galah-x/SwingGate/README.md

# SwingGate
Controller for an electric remote controlled swing farm gate
