galah-x/SwingGate/swinggate/swinggate_BOM.ods

Id | Designator | Package | Quantity | Designation | Supplier and ref
1 | U3 | IBT_2 | 1 | IBT2_HBRIDGE | https://www.ebay.com.au/itm/Semiconductor-Motor-Driver-Auto-BTS7960-43A-H-Bridge-PWM-Drive-For-Arduino-U1C6-/302749142576
3 | C1,C2,C3,C4,C5 | C_0805_2012Metric_Pad1.15x1.40mm_HandSolder | 5 | 100N
4 | D1 | D_SMA-SMB_Universal_Handsoldering | 1 | APD240VR
5 | J1,J3,J4,J5 | PhoenixContact_MC_1,5_2-G-5.08_1x02_P5.08mm_Horizontal | 4 | Conn_01x02_Female | https://www.ebay.com.au/itm/10pcs-5-08mm-2-EDG-2-Pin-Plug-in-Right-Angle-PCB-Screw-Terminal-Block-Connector/292835245321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
6 | Q1 | TO-263-3_TabPin2 | 1 | IPB081
7 | R3 | R_0805_2012Metric_Pad1.15x1.40mm_HandSolder | 1 | 402K
8 | R4,R9,R10,R11,R13,R15 | R_0805_2012Metric_Pad1.15x1.40mm_HandSolder | 6 | 100K
9 | R5,R6 | R_0805_2012Metric_Pad1.15x1.40mm_HandSolder | 2 | 10K
10 | R7,R8 | R_0805_2012Metric_Pad1.15x1.40mm_HandSolder | 2 | 1K2
11 | R12,R14,R16 | R_0805_2012Metric_Pad1.15x1.40mm_HandSolder | 3 | 33K
12 | U1 | switcher1 | 1 | switcher1 | https://www.ebay.com.au/itm/DC-DC-9V-12V-19V-To-3A-5V-3-3V-USB-Step-Down-Buck-Power-Supply-Module-For-Car/282743651974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
13 | U2 | DIP-26_W0.8_Socket | 1 | Moteino_hcw | https://lowpowerlab.com/shop/product/99
14 | J2 | PhoenixContact_MC_1,5_4-G-5.08_1x04_P5.08mm_Horizontal | 1 | Conn_01x04_Female | https://www.ebay.com.au/itm/9Pairs-4Pole-5-08mm-Plug-Type-Pitch-PCB-Mount-with-Right-Angle-Pin-B9U1/273040528477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
 | additional mechanical
 |  | threaded standoff 25mm m3 | 4 | for U3 | https://www.ebay.com.au/itm/100pcs-M3-5-25mm-Black-PA66-Nylon-Hexagon-Female-Threaded-Standoff-Spacer-Pillar/182482464251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
 |  | 8 pin header | 1 | for U3
 |  | ribbon cable 8 pin idc socket | 2 | for U3 | https://www.ebay.com.au/itm/2-54mm-FC-6-51-Way-IDC-Female-Flat-Ribbon-Cable-Mounting-Socket-Connector-Kit/222895237965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
 |  | ribbon cable 50mm | 1 | for U3
 |  | m3 machine screw 6mm | 8 | for U3 | https://www.ebay.com.au/itm/M3x10mm-316-Stainless-Steel-Phillips-Round-Pan-Head-Machine-Screw-Bolt-60pcs/352046660471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
 |  | pin strip x 13 mc screw female | 2 | for U2 | https://www.ebay.com.au/itm/2-10x-Strip-Tin-PCB-Female-IC-Breakable-40pin-Single-Row-Round-Header-Socket/161925149885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
 |  | pin strip x 13 mc screw male | 2 | for U2 | https://www.ebay.com.au/itm/20pcs-40Pin-2-54mm-Male-Female-Header-Socket-Row-Straight-Strip-PCB-Connector/152053905428
