galah-x/SwingGate/SwingGate.pdf

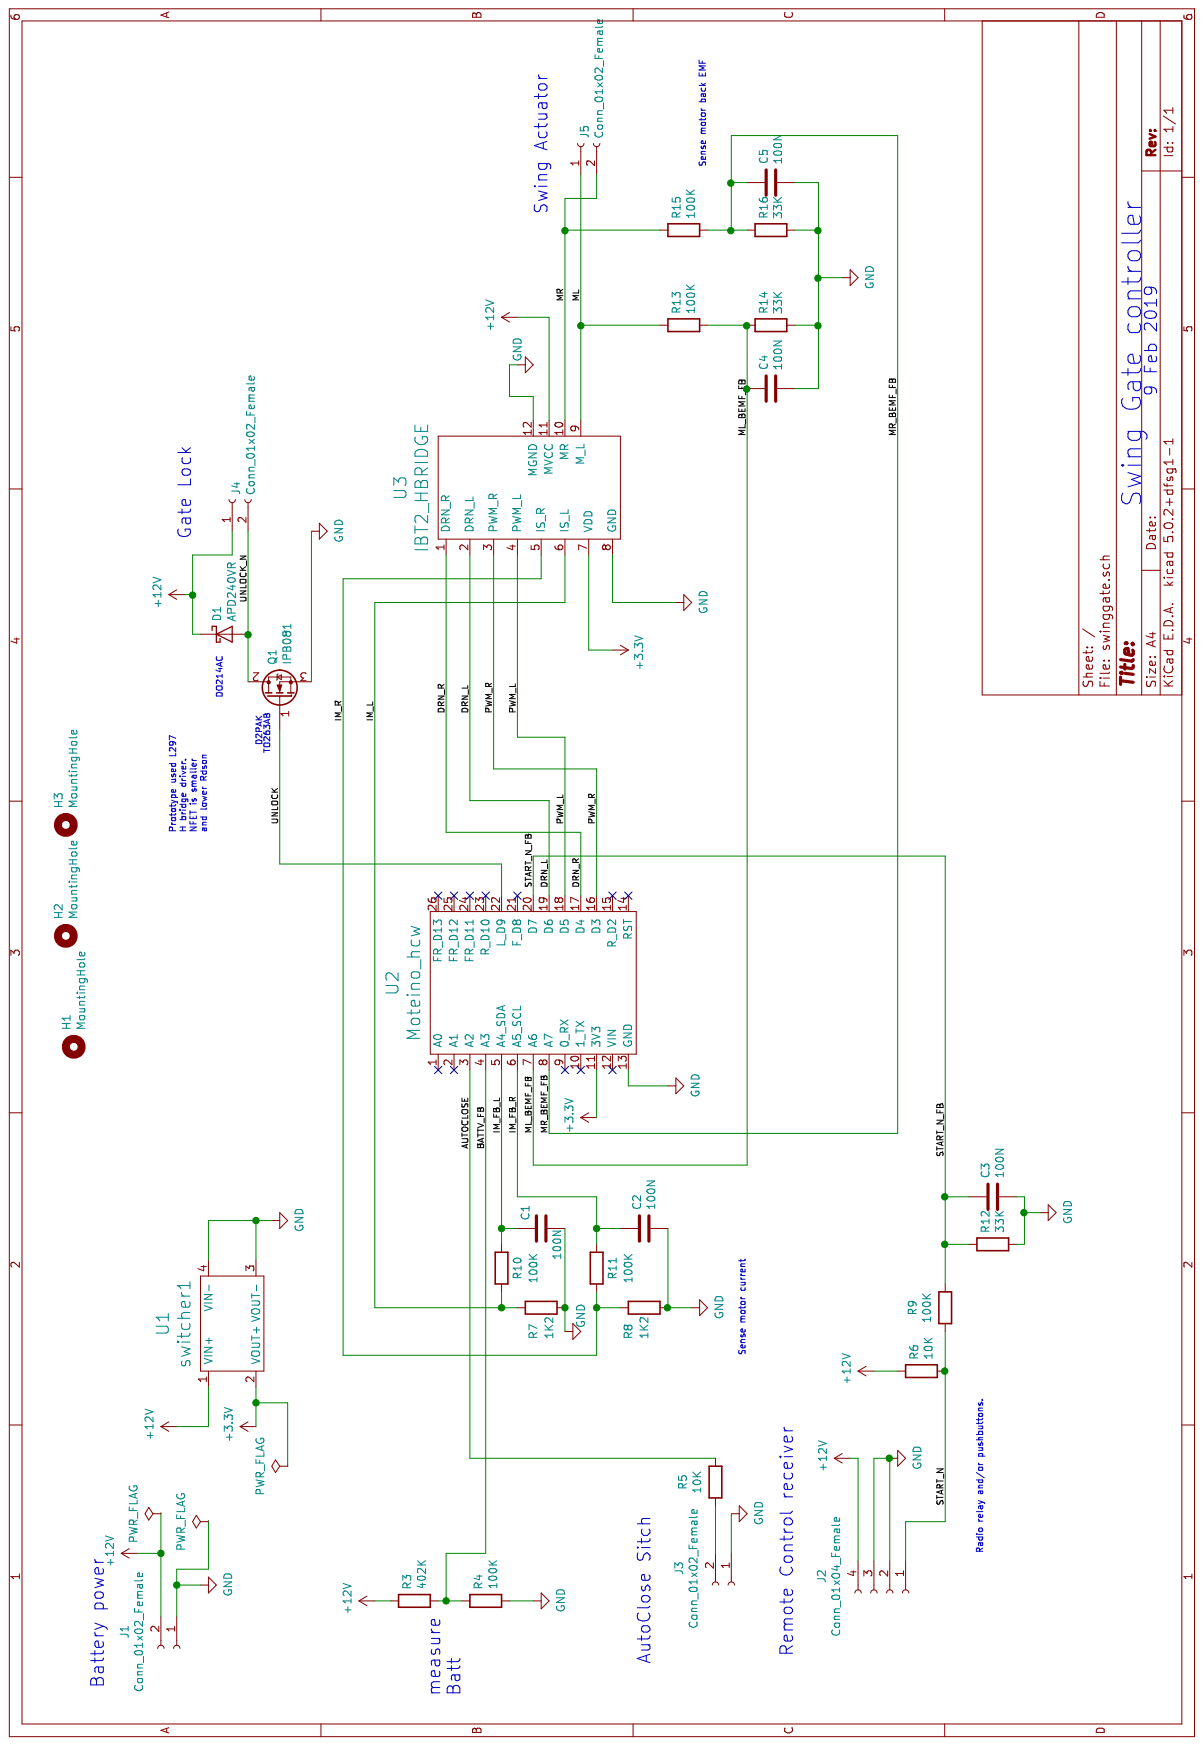
[picture p1: page 1]
