galah-x/SwingGate/swinggate/swinggate.kicad_pcb

## KiCad design swinggate/swinggate.kicad_pcb (2019-02-10)

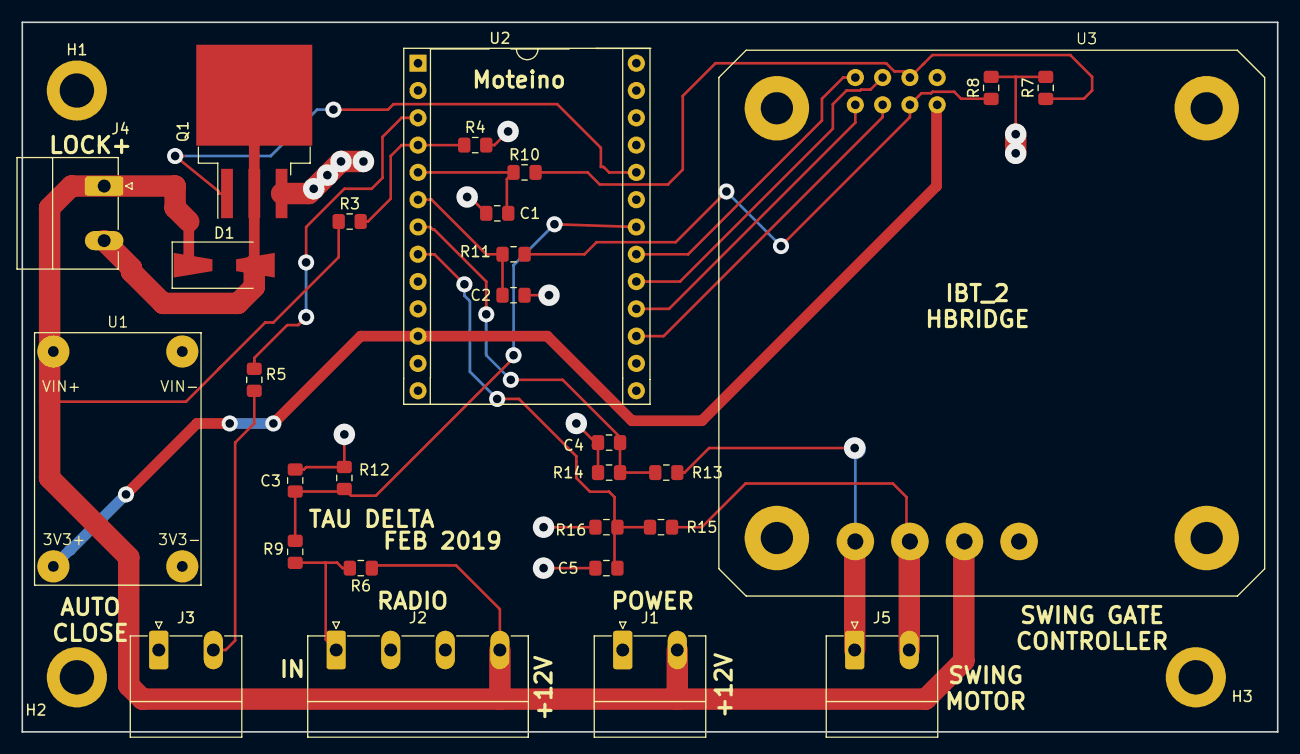
[picture p2: board swinggate.kicad_pcb from above]

Board: 2 copper layers, 116.8 x 66.0 mm, 32 parts (0 on the bottom side), 22 nets.

Parts:
C1, C2, C3, C4, C5: 100N; C_0805_2012Metric_Pad1.15x1.40mm_HandSolder
D1: APD240VR; D_SMA-SMB_Universal_Handsoldering
H1, H2, H3: MountingHole; MountingHole_3.2mm_M3_DIN965_Pad
J1, J3, J4, J5: Conn_01x02_Female; PhoenixContact_MC_1,5_2-G-5.08_1x02_P5.08mm_Horizontal
J2: Conn_01x04_Female; PhoenixContact_MC_1,5_4-G-5.08_1x04_P5.08mm_Horizontal
Q1: IPB081; TO-263-3_TabPin2
R3: 402K; R_0805_2012Metric_Pad1.15x1.40mm_HandSolder
R4, R9, R10, R11, R13, R15: 100K; R_0805_2012Metric_Pad1.15x1.40mm_HandSolder
R5, R6: 10K; R_0805_2012Metric_Pad1.15x1.40mm_HandSolder
R7, R8: 1K2; R_0805_2012Metric_Pad1.15x1.40mm_HandSolder
R12, R14, R16: 33K; R_0805_2012Metric_Pad1.15x1.40mm_HandSolder
U1: switcher1
U2: Moteino_hcw; DIP-26_W0.8_Socket
U3: IBT2_HBRIDGE; IBT_2

Connections:
+3V3: U1.2, U2.11, U3.7
+12V: D1.1, J1.2, J2.4, J4.1, R3.1, R6.1, U1.1, U3.11
/AUTOCLOSE: R5.1, U2.3
/BATTV_FB: R3.2, R4.1, U2.4
/DRN_L: U2.19, U3.2
/DRN_R: U2.17, U3.1
/IM_FB_L: C1.1, R10.1, U2.5
/IM_FB_R: C2.1, R11.1, U2.6
/IM_L: R7.1, R10.2, U3.6
/IM_R: R8.1, R11.2, U3.5
/ML: J5.1, R13.1, U3.9
/ML_BEMF_FB: C4.1, R13.2, R14.1, U2.7
/MR: J5.2, R15.1, U3.10
/MR_BEMF_FB: C5.1, R15.2, R16.1, U2.8
/PWM_L: U2.18, U3.4
/PWM_R: U2.16, U3.3
/START_N: J2.1, R6.2, R9.2
/START_N_FB: C3.1, R9.1, R12.1, U2.20
/UNLOCK: Q1.1, U2.22
/UNLOCK_N: D1.2, J4.2, Q1.2
GND: C1.2, C2.2, C3.2, C4.2, C5.2, J1.1, J2.2, J2.3, J3.1, Q1.3, R4.2, R7.2, R8.2, R12.2, R14.2, R16.2, U1.3, U1.4, U2.13, U3.8, U3.12
unnamed: J3.2, R5.2
