galah-x/SwingGate/(commit log)

2019-01-28 basic motor speed control works now
2019-01-28 basic motor speed control. backemf ok, current needs more headroom
2019-01-28 rescaled current wihth 1k2 paralleled.
2019-02-05 added manual jogging on button
2019-02-05 ticks reset in wrong place
    [SwingGate.ino]
2019-02-10 do a pcb with Kicad
    [swinggate-B.Cu.gbr, swinggate-B.Mask.gbr, swinggate-Edge.Cuts.gbr, swinggate-F.Cu.gbr, swinggate-F.Mask.gbr, swinggate-F.SilkS.gbr, swinggate-NPTH.drl, swinggate-PTH.drl]
2019-02-11 add radio control and reversing at start/closed to allow lock to release
    [SwingGate.ino]
2019-03-04 initial build onto backgate. backemf was swapped. Not tuned correctly yet.
    [SwingGate.ino]
2019-03-10 log to gateway, more time in run_slow, less in missed_limit
    [SwingGate.ino]
2019-03-10 tweak bemf, show drn, to stopped state on stall.
    [SwingGate.ino]
2019-03-23 change fast current lim
2019-03-27 fix sign bug if swing too fast. Also leave autoclose enabled on fast stall open
    [SwingGate.ino]
2020-01-18 start to make direction limits separate adn add proximity switches
2020-02-15 allow to ignore lock pin
2020-04-17 restructure front and back separation, hopefully fix timeout breakage
    [SwingGate.ino, whichgate.h]
2020-04-18 change print id
2020-04-18 change buttoned to a bool, re enable button_auto=false if button pressed when not closed.
2021-04-05 tweak bckgate constants for 16V 4S4P LiPo
