galah-x/SwingGate/(notices)

Notices in the files:
SwingGateTuner/SwingGateTuner.ino:
Copyright Felix Rusu 2016, http://www.LowPowerLab.com/contact
Public License as published by the Free Software
